Jasdoge/HalloweenEyes/Assets/circuit.png

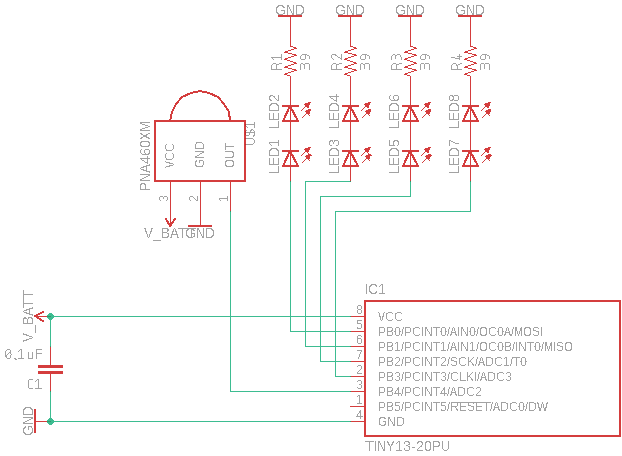
Assets/circuit.png
