Jasdoge/HalloweenEyes/Assets/eyebox_lid.STL

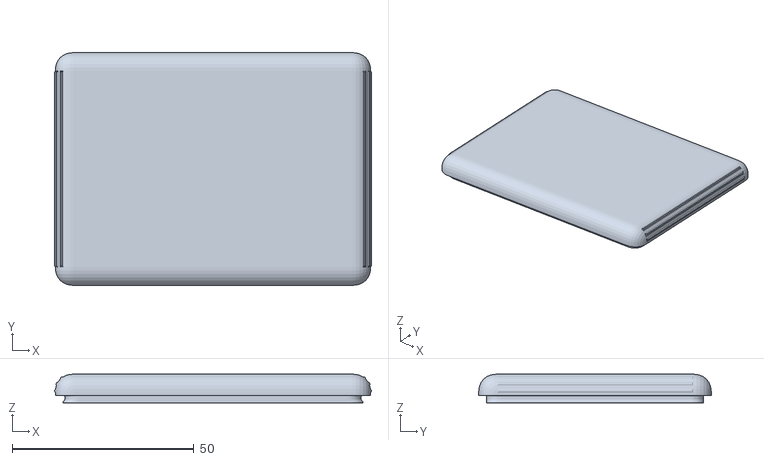
[picture p2: CAD file, 2019-10-27]
Assets/eyebox_lid.STL
87.2 x 64.0 x 7.90
