Jasdoge/HalloweenEyes/Assets/eyebox_base.STL

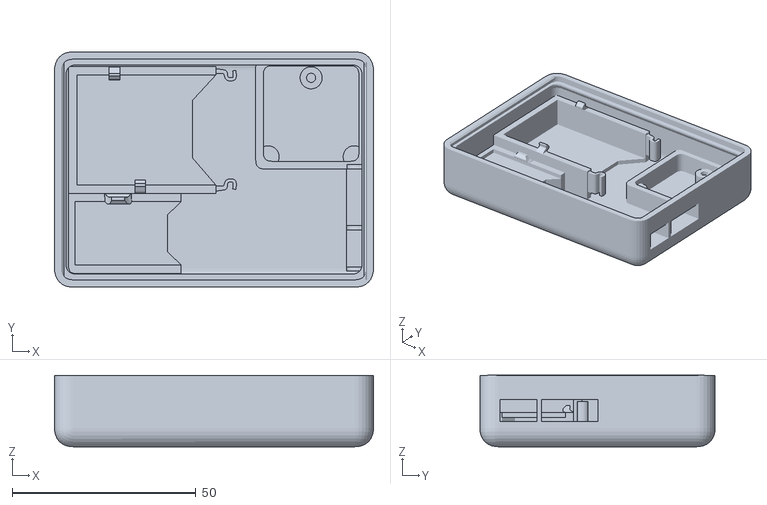
[picture p3: CAD file, 2019-10-27]
Assets/eyebox_base.STL
86.7 x 64.0 x 19.5
