Jasdoge/HalloweenEyes/Assets/pir_box.STL

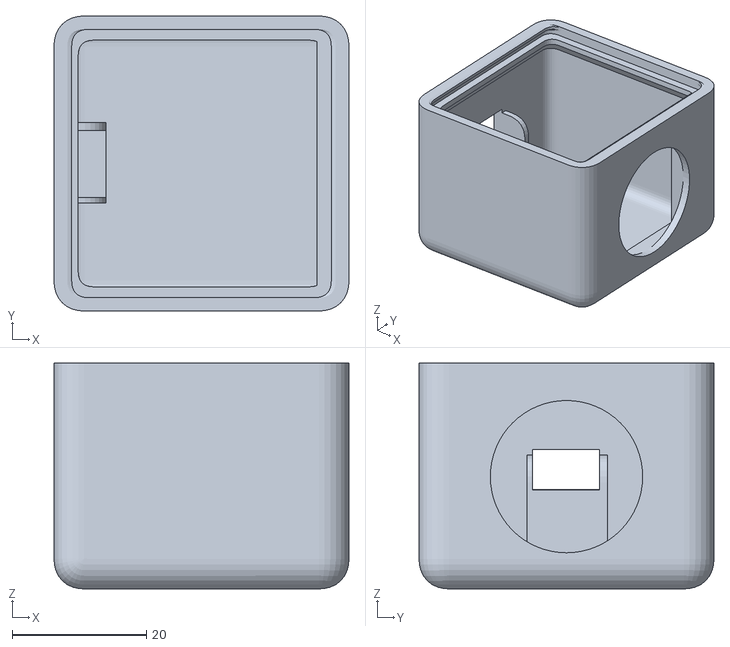
[picture p4: CAD file, 2019-10-27]
Assets/pir_box.STL
44.0 x 44.0 x 33.7
