Jasdoge/HalloweenEyes/Assets/eye_base.STL

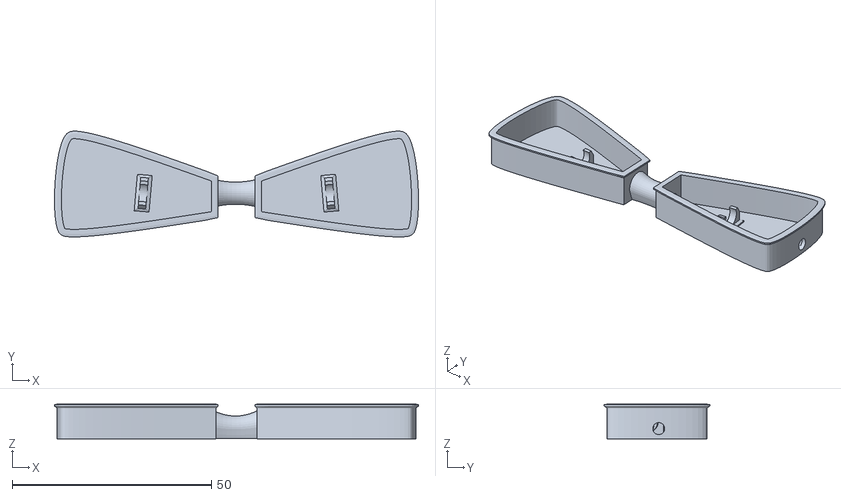
[picture p5: CAD file, 2019-10-27]
Assets/eye_base.STL
91.4 x 26.6 x 8.70
