Jasdoge/HalloweenEyes/Assets/eye_lid.STL

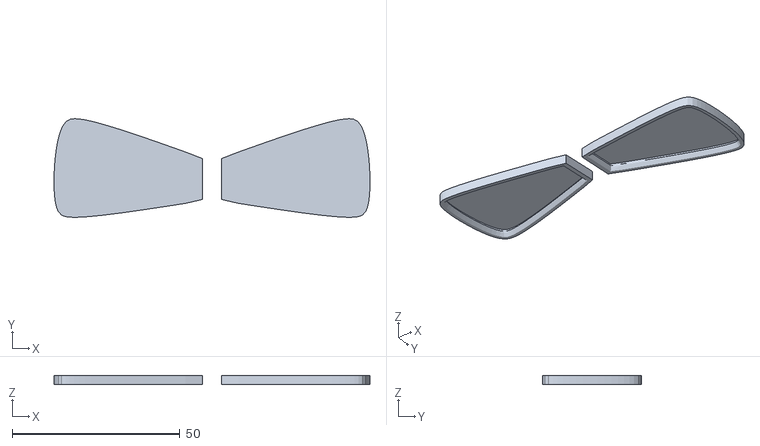
[picture p6: CAD file, 2019-10-27]
Assets/eye_lid.STL
94.2 x 29.4 x 2.80
