Jasdoge/HalloweenEyes/Assets/pir_box_lid.STL

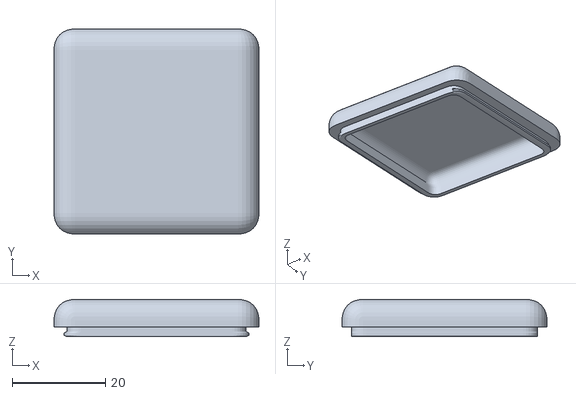
[picture p7: CAD file, 2019-10-27]
Assets/pir_box_lid.STL
44.0 x 44.0 x 7.97
