Jasdoge/HalloweenEyes/Assets/main.sch

## EAGLE design Assets/main.sch (2019-10-27)

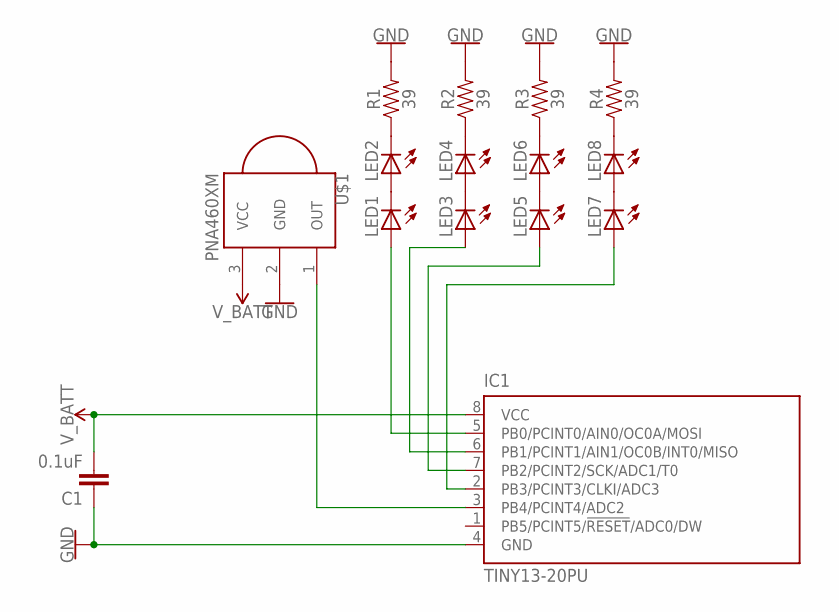
[picture p8: schematic main.sch]

Parts:
C1: 0.1uF; CAP-PTH-SMALL-KIT
IC1: TINY13-20PU; DIL08
LED1, LED2, LED3, LED4, LED5, LED6, LED7, LED8: LED5MM
R1, R2, R3, R4: 39; 0603
U$1: PNA460XM

Connections:
GND: C1.1, IC1.4 (GND), R1.2, R2.2, R3.2, R4.2, U$1.2 (GND)
unnamed: LED1.K (C), LED2.A
unnamed: LED2.K (C), R1.1
unnamed: IC1.3 (PB4/PCINT4/ADC2), U$1.1 (OUT)
unnamed: LED3.K (C), LED4.A
unnamed: LED4.K (C), R2.1
unnamed: LED5.K (C), LED6.A
unnamed: LED6.K (C), R3.1
unnamed: LED7.K (C), LED8.A
unnamed: LED8.K (C), R4.1
unnamed: IC1.5 (PB0/PCINT0/AIN0/OC0A/MOSI), LED1.A
unnamed: IC1.6 (PB1/PCINT1/AIN1/OC0B/INT0/MISO), LED3.A
unnamed: IC1.7 (PB2/PCINT2/SCK/ADC1/T0), LED5.A
unnamed: IC1.2 (PB3/PCINT3/CLKI/ADC3), LED7.A
V_BATT: C1.2, IC1.8 (VCC), U$1.3 (VCC)
